EnacheVictor/Voltage-Stabilizer/Proiect docs/CamScanner 2024-11-12 16.13.pdf

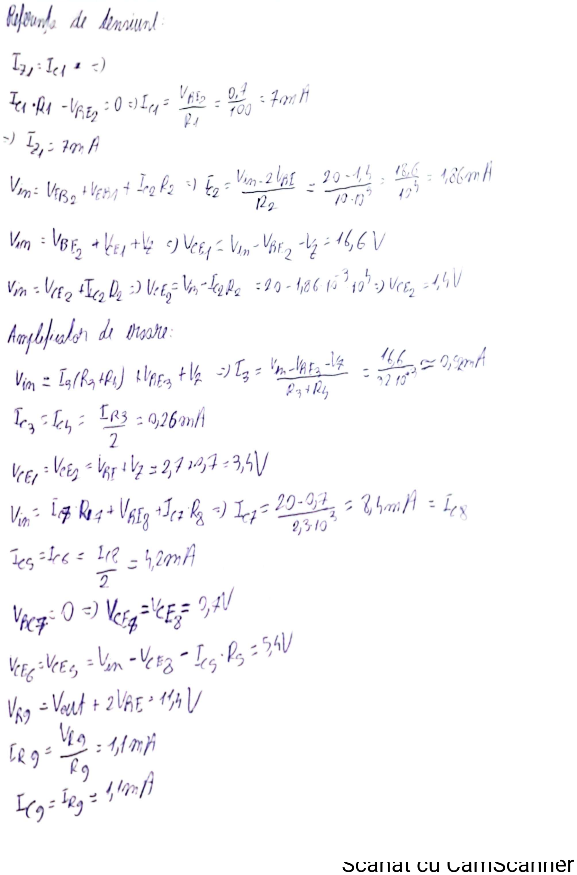
[picture p9: page 1]
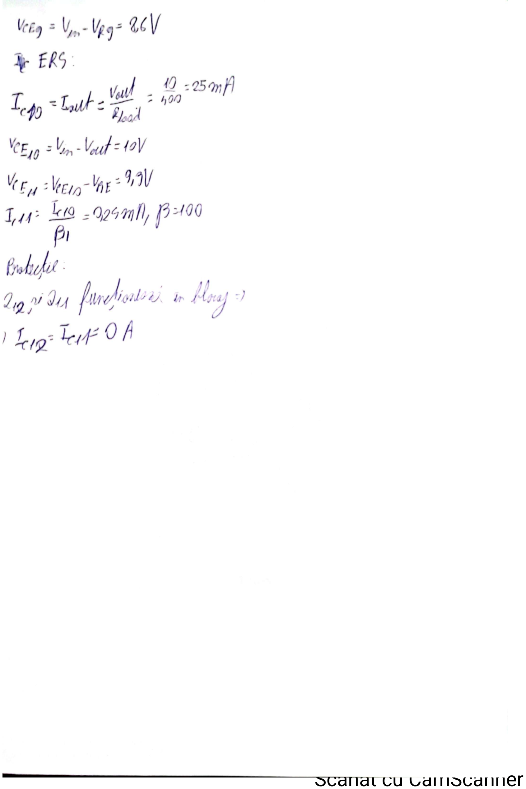
[picture p10: page 2]
