EnacheVictor/Voltage-Stabilizer/Schematics/Proiect1_Enache_Victor.jpg

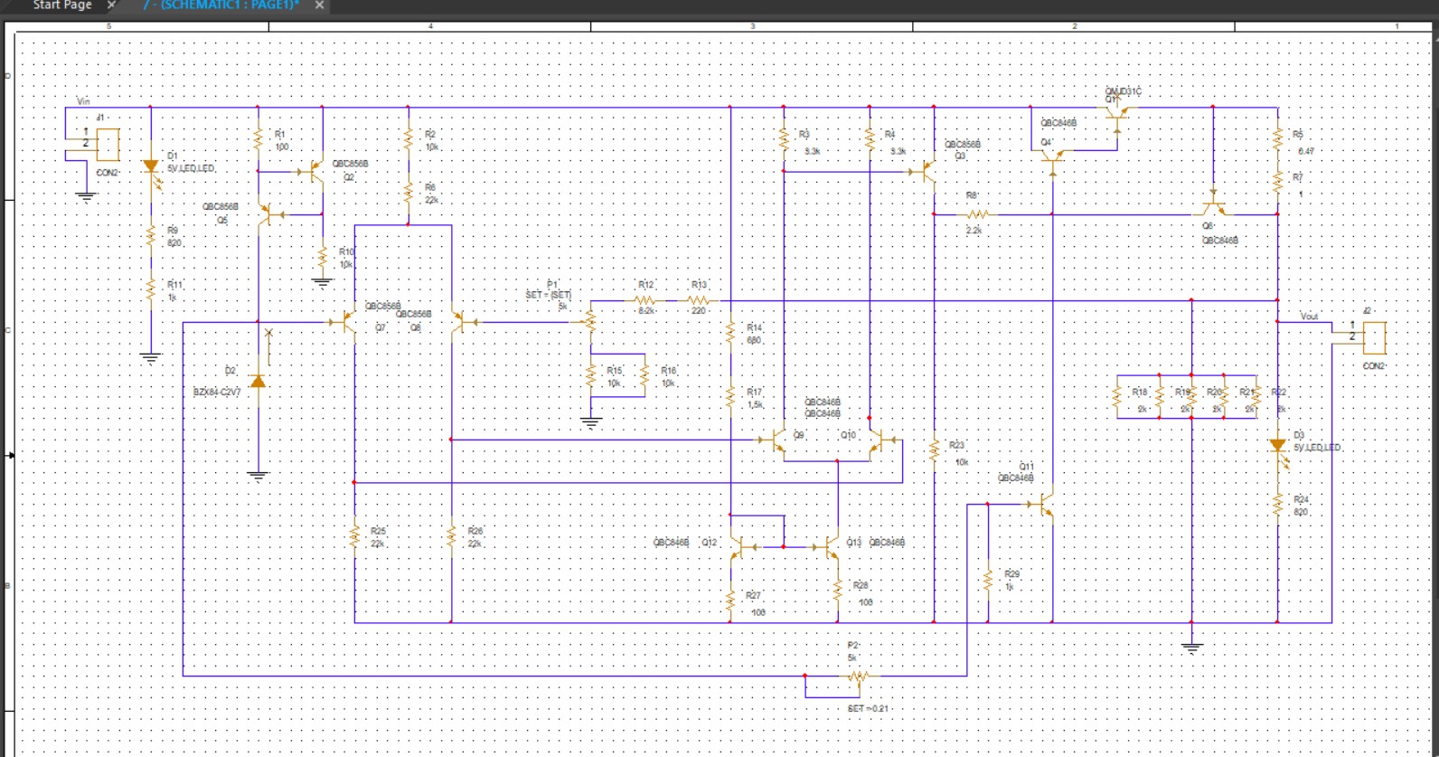
Schematics/Proiect1_Enache_Victor.jpg
