EnacheVictor/Voltage-Stabilizer/Schematics/Proiect/PROIECT1_ENACHEVICTOR.png

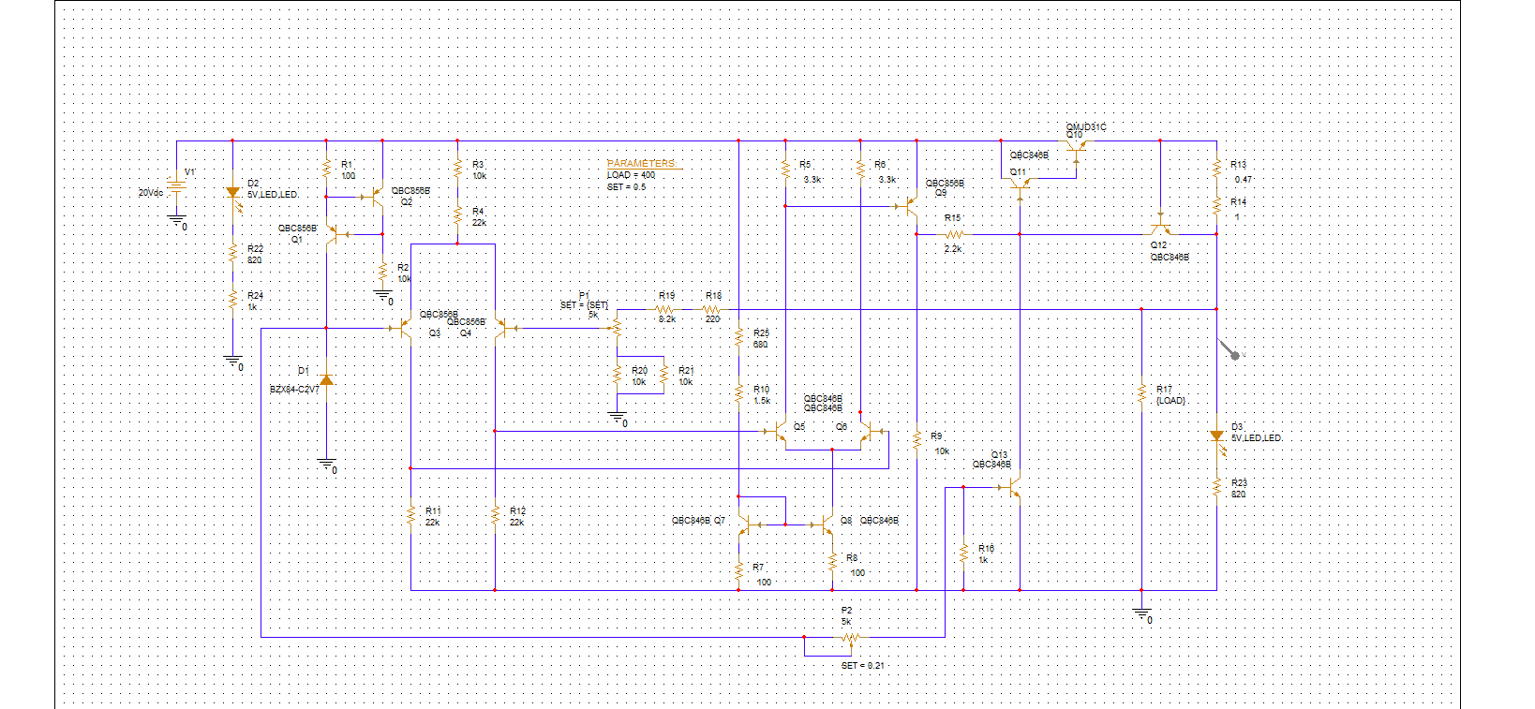
Schematics/Proiect/PROIECT1_ENACHEVICTOR.png
