EnacheVictor/Voltage-Stabilizer/Simulations/bucla deschisa.jpg

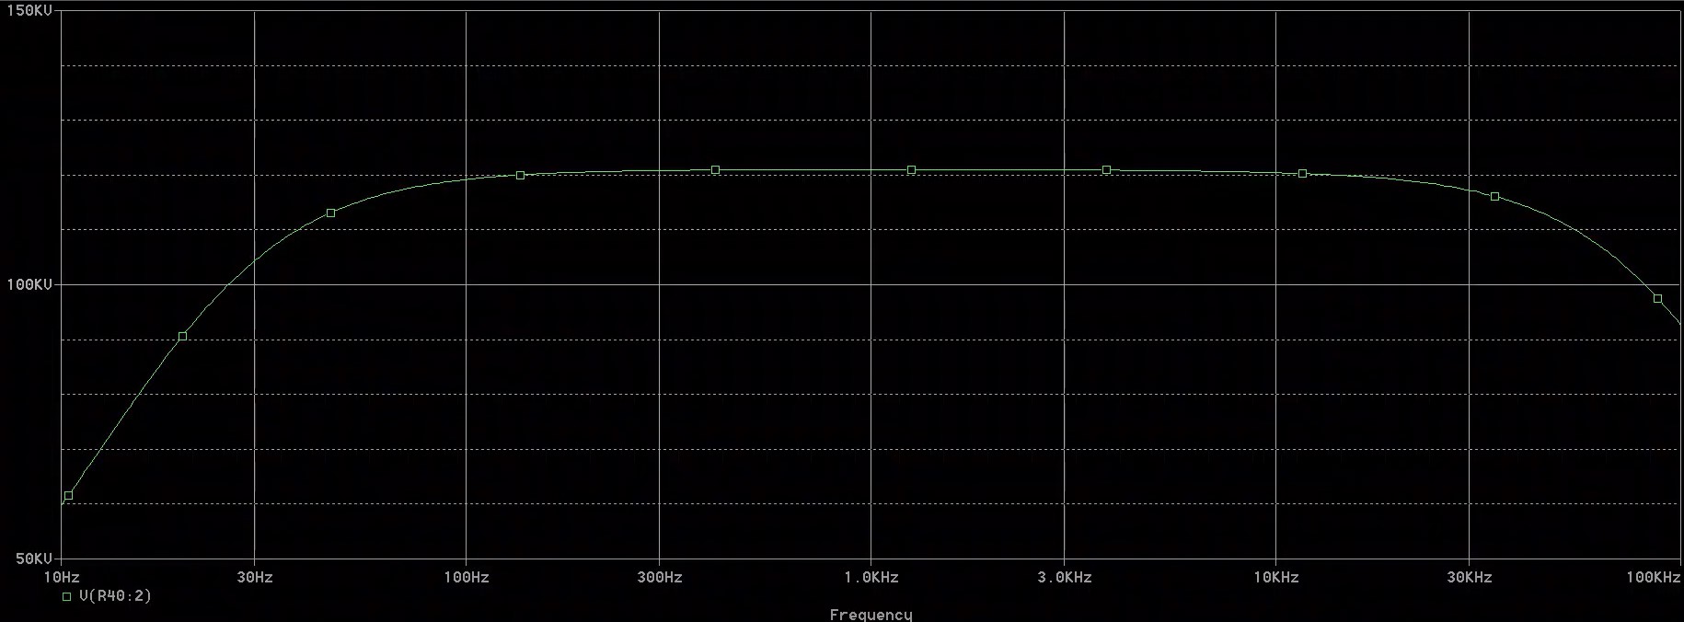
Simulations/bucla deschisa.jpg
