EnacheVictor/Voltage-Stabilizer/Simulations/Protectie supra curent.jpg

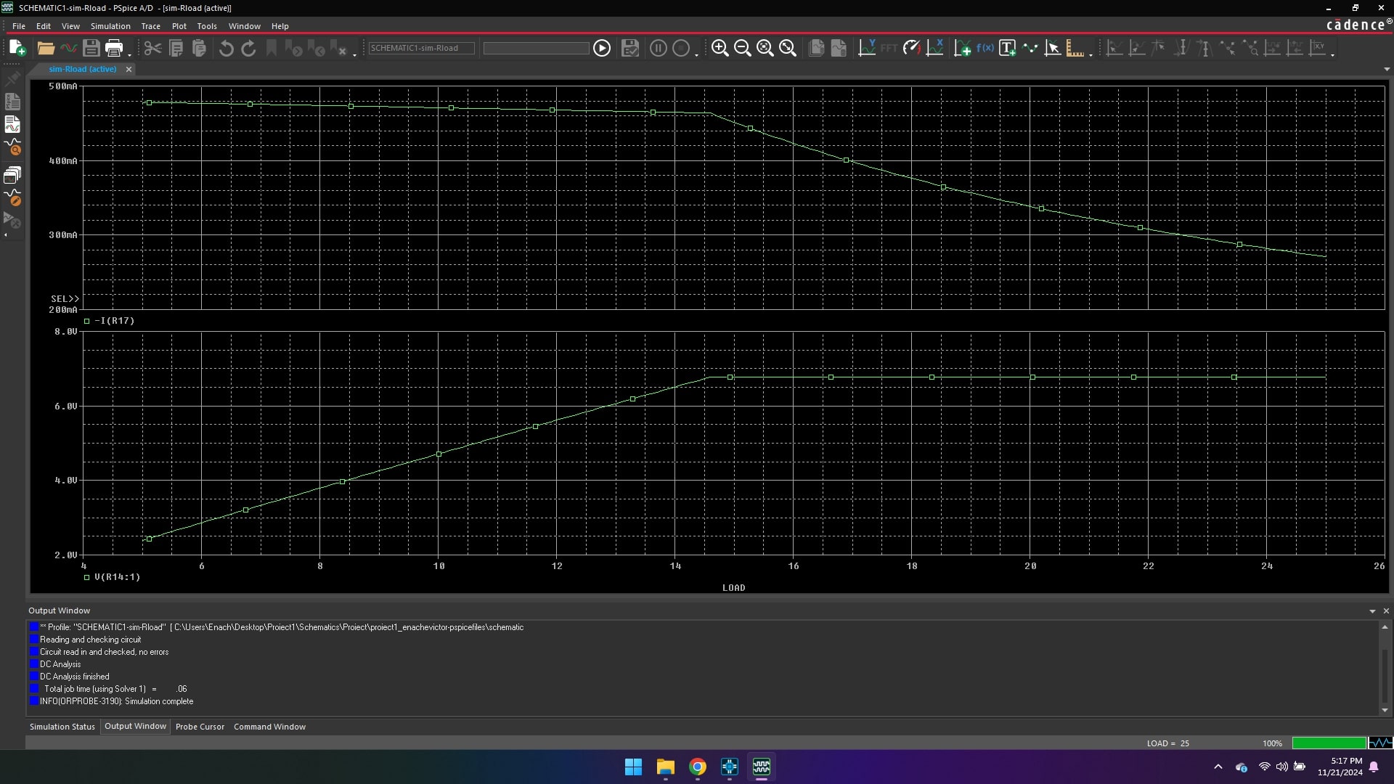
Simulations/Protectie supra curent.jpg
