EnacheVictor/Voltage-Stabilizer/Simulations/protectie temperatura.jpg

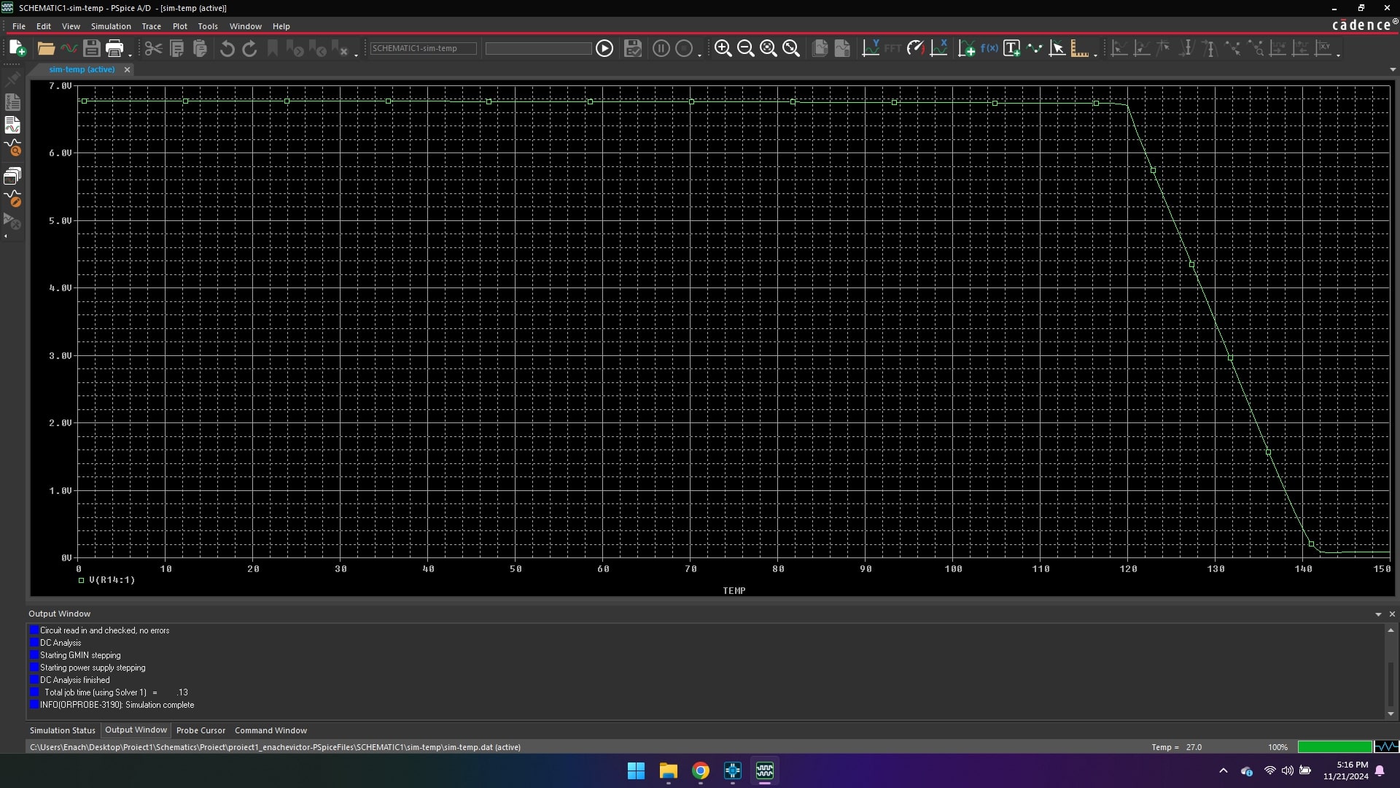
Simulations/protectie temperatura.jpg
