EnacheVictor/Voltage-Stabilizer/Simulations/stabilizator.jpg

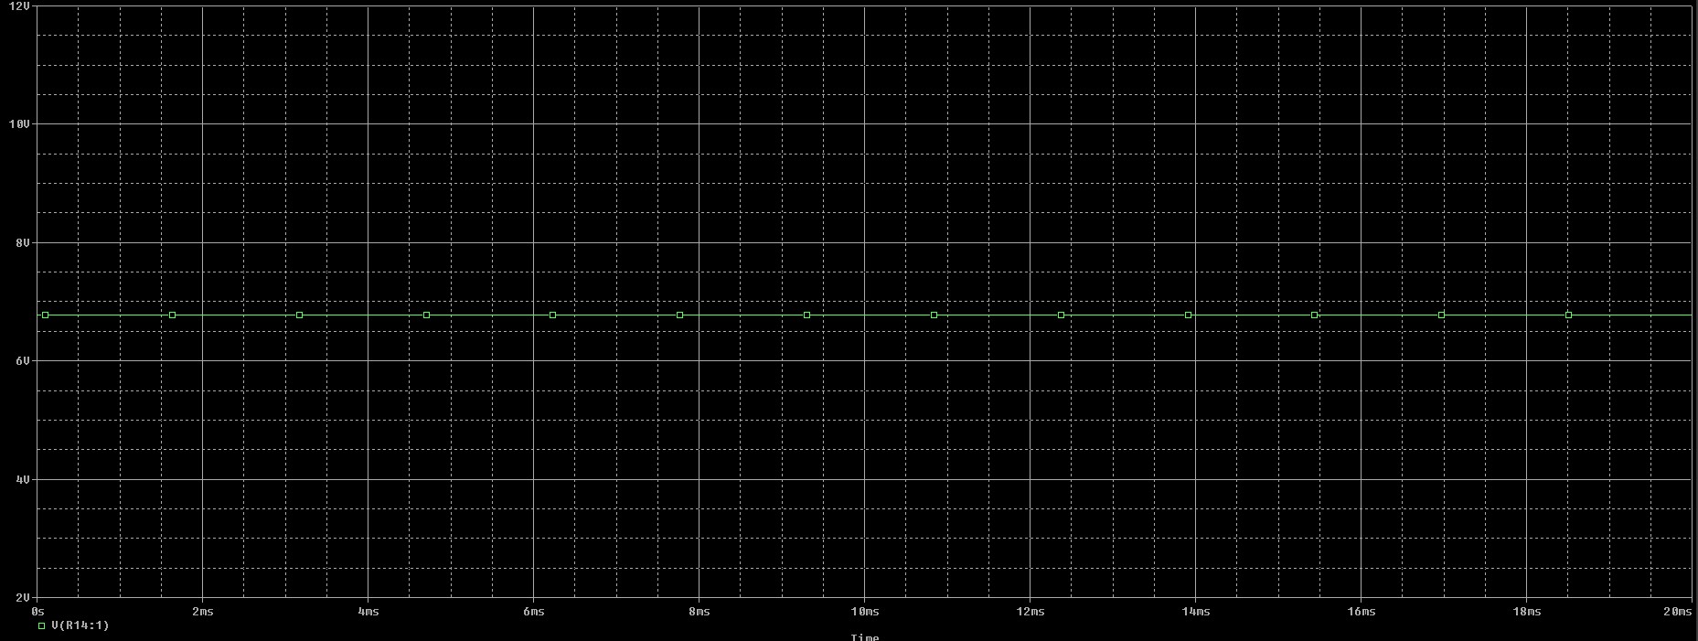
Simulations/stabilizator.jpg
