EnacheVictor/Voltage-Stabilizer/Simulations/Vin 18-20V.jpg

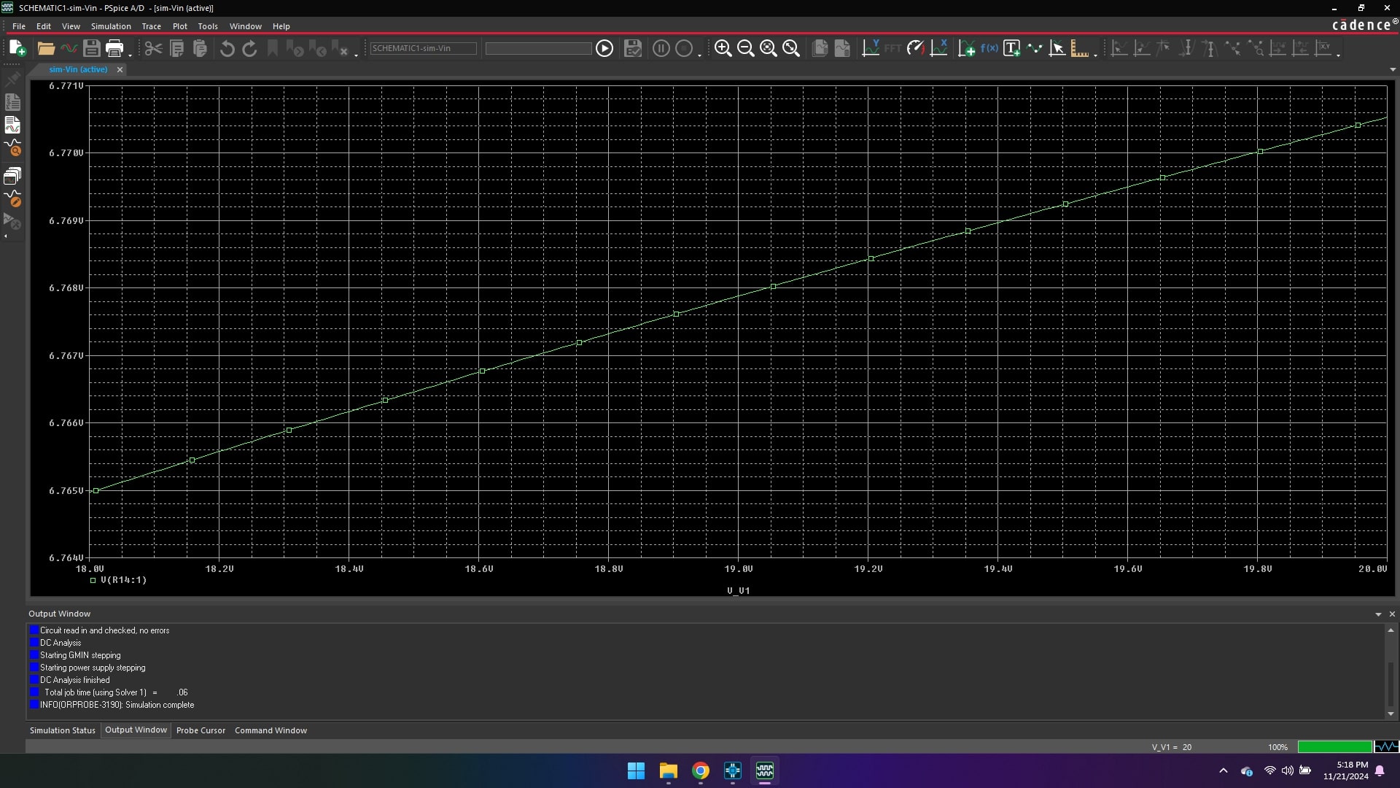
Simulations/Vin 18-20V.jpg
