EnacheVictor/Voltage-Stabilizer/Simulations/Vout 5-10V.jpg

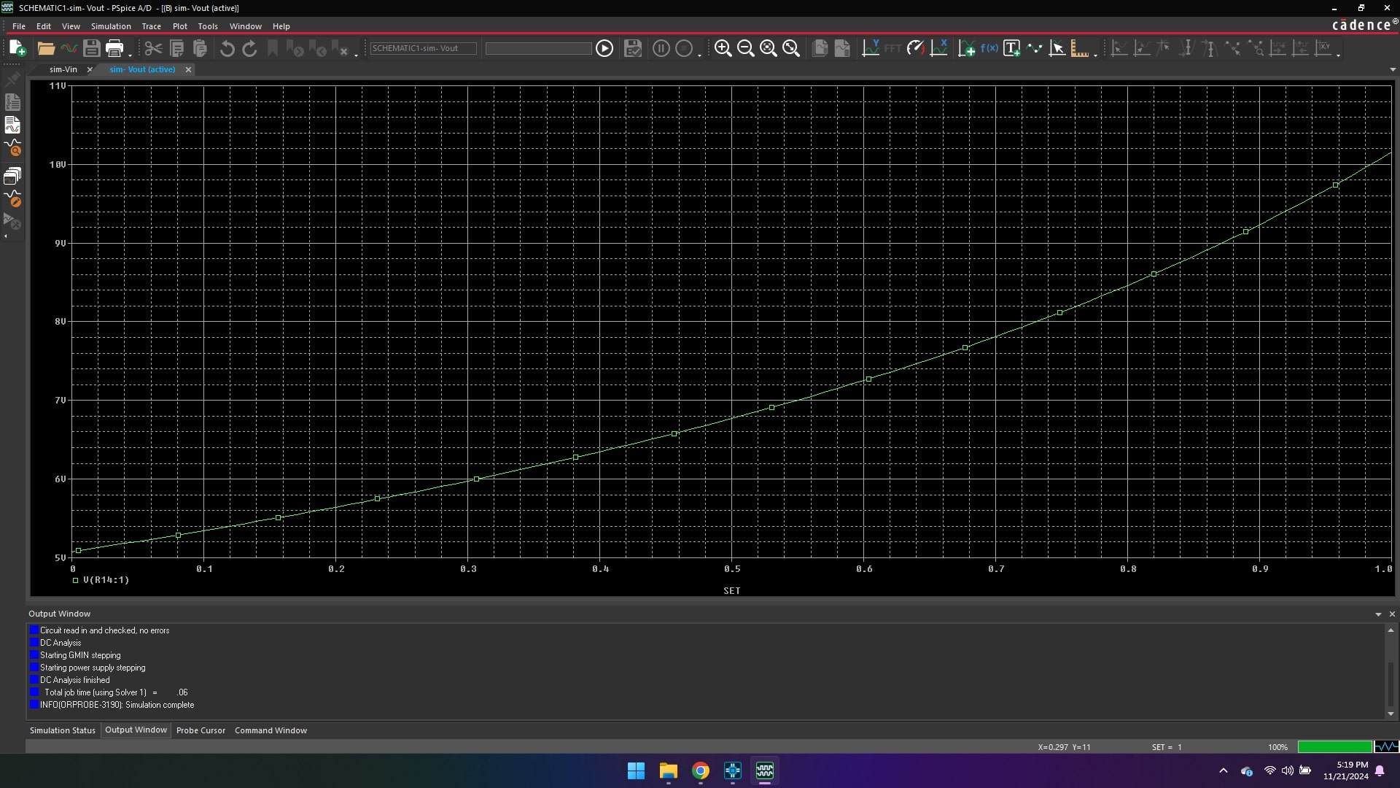
Simulations/Vout 5-10V.jpg
