EnacheVictor/Voltage-Stabilizer/Schematics/MJD31CG.stp

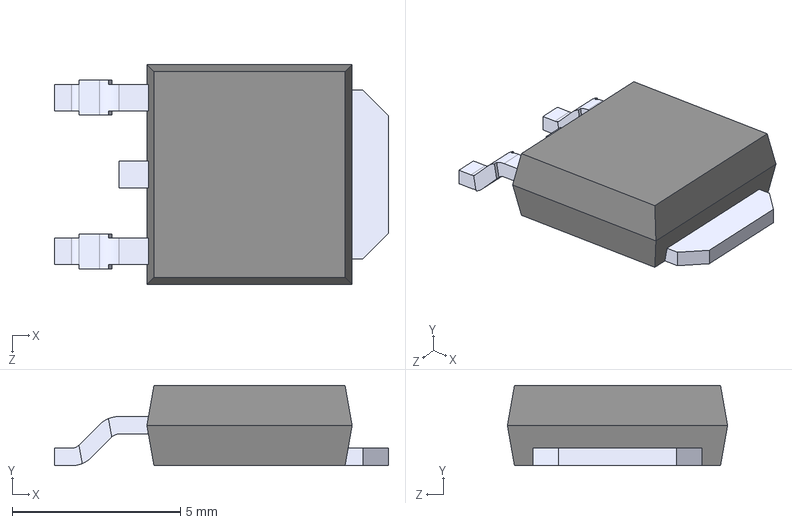
[picture p19: CAD file, 2025-03-27]
Schematics/MJD31CG.stp
9.92 x 2.39 x 6.54 mm
MAC4DCMT4G_5
MAC4DCMT4G
MAC4DCMT4G_4
MAC4DCMT4G_3
MAC4DCMT4G_2
