EnacheVictor/Voltage-Stabilizer/Schematics/BC846B.stp

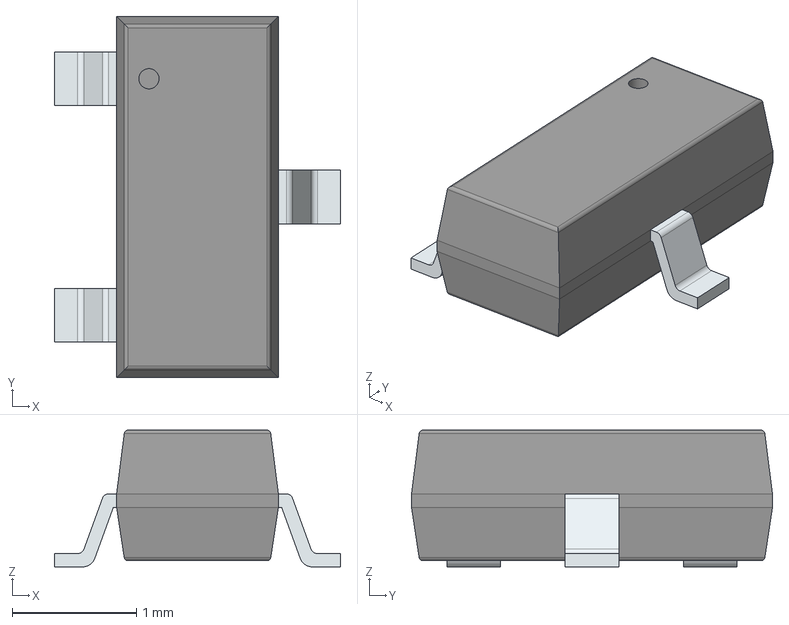
[picture p20: CAD file, 2025-03-27]
Schematics/BC846B.stp
2.30 x 2.90 x 1.10 mm
PinsArrayL
FilletPinR
