EnacheVictor/Voltage-Stabilizer/Schematics/res.stp

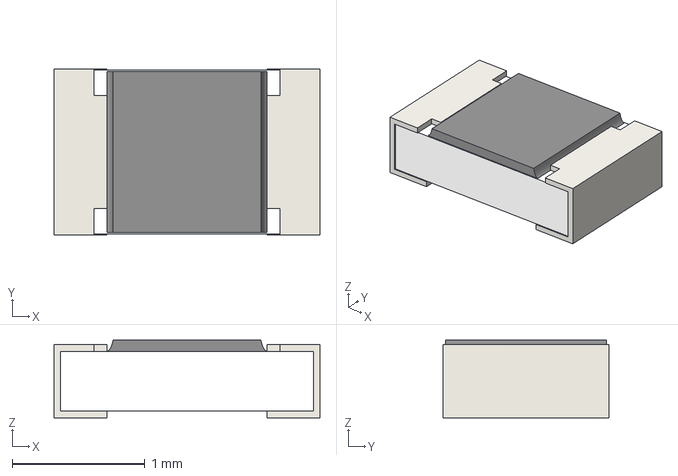
[picture p21: CAD file, 2025-03-27]
Schematics/res.stp
2.00 x 1.25 x 0.585 mm
