EnacheVictor/Voltage-Stabilizer/Schematics/OF-SMD2012B.stp

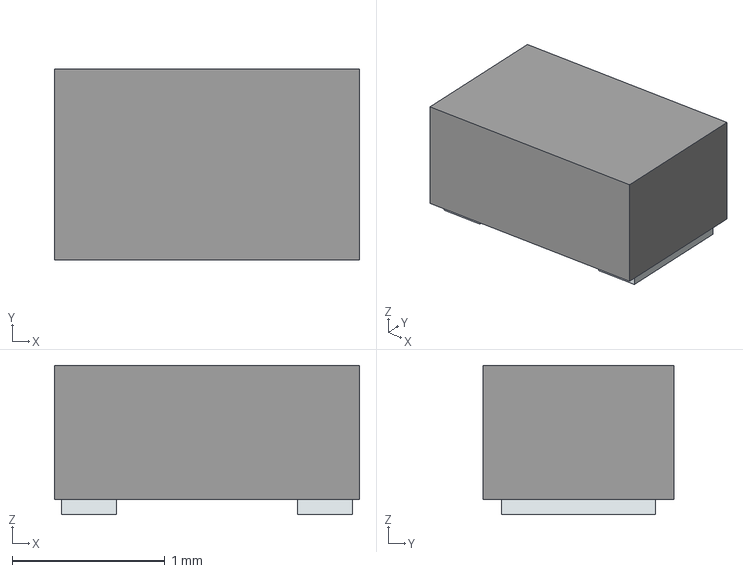
[picture p22: CAD file, 2025-03-27]
Schematics/OF-SMD2012B.stp
2.00 x 1.25 x 0.98 mm
Pins
