EnacheVictor/Voltage-Stabilizer/Schematics/3314G-1-103E.stp

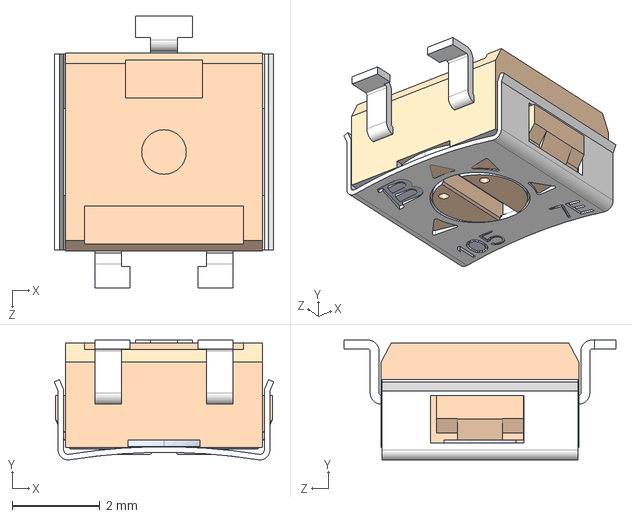
[picture p23: CAD file, 2025-03-27]
Schematics/3314G-1-103E.stp
5.00 x 2.73 x 6.20 mm
