EnacheVictor/Voltage-Stabilizer/Schematics/ZL301-40P.stp

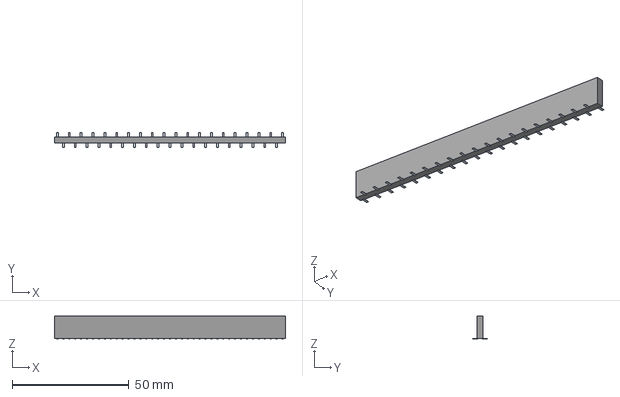
[picture p24: CAD file, 2025-03-27]
Schematics/ZL301-40P.stp
99.1 x 6.50 x 9.80 mm
Pins
