EnacheVictor/Voltage-Stabilizer/(list of files, drawings)

Other design files:
Schematics/biblioteci spice/1N4148.OLB
Schematics/biblioteci spice/1n4148.opj
Schematics/biblioteci spice/BC807-25.OLB
Schematics/biblioteci spice/bc807-25.opj
Schematics/biblioteci spice/BC817-25.OLB
Schematics/biblioteci spice/bc817-25.opj
Schematics/biblioteci spice/BC846B.OLB
Schematics/biblioteci spice/BC856B.OLB
Schematics/biblioteci spice/BZX84C2V7.OLB
Schematics/biblioteci spice/BZX84C5V1.OLB
Schematics/biblioteci spice/BZX84C5V6.OLB
Schematics/biblioteci spice/BZX84C6V2.OLB
Schematics/biblioteci spice/BZX84C6V8.OLB
Schematics/biblioteci spice/BZX84C10.OLB
Schematics/biblioteci spice/diode.olb
Schematics/biblioteci spice/ebipolar.olb
Schematics/biblioteci spice/IRFR120NPBF.OLB
Schematics/biblioteci spice/MJD31CG.OLB
Schematics/biblioteci spice/MJD32CG.OLB
Schematics/biblioteci spice/MMBFJ177LT1G.OLB
Schematics/biblioteci spice/MMBFJ309LT1G.OLB
Schematics/biblioteci spice/opto.olb
Schematics/PROIECT1_ENACHEVICTOR.DSN
Schematics/Proiect1_EnacheVictor.opj
Schematics/Proiect/biblioteci spice/1N4148.OLB
Schematics/Proiect/biblioteci spice/1n4148.opj
Schematics/Proiect/biblioteci spice/BC807-25.OLB
Schematics/Proiect/biblioteci spice/bc807-25.opj
Schematics/Proiect/biblioteci spice/BC817-25.OLB
Schematics/Proiect/biblioteci spice/bc817-25.opj
Schematics/Proiect/biblioteci spice/BC846B.OLB
Schematics/Proiect/biblioteci spice/BC856B.OLB
Schematics/Proiect/biblioteci spice/BZX84C2V7.OLB
Schematics/Proiect/biblioteci spice/BZX84C5V1.OLB
Schematics/Proiect/biblioteci spice/BZX84C5V6.OLB
Schematics/Proiect/biblioteci spice/BZX84C6V2.OLB
Schematics/Proiect/biblioteci spice/BZX84C6V8.OLB
Schematics/Proiect/biblioteci spice/BZX84C10.OLB
Schematics/Proiect/biblioteci spice/diode.olb
Schematics/Proiect/biblioteci spice/ebipolar.olb
Schematics/Proiect/biblioteci spice/IRFR120NPBF.OLB
Schematics/Proiect/biblioteci spice/MJD31CG.OLB
Schematics/Proiect/biblioteci spice/MJD32CG.OLB
Schematics/Proiect/biblioteci spice/MMBFJ177LT1G.OLB
Schematics/Proiect/biblioteci spice/MMBFJ309LT1G.OLB
Schematics/Proiect/biblioteci spice/opto.olb
Schematics/Proiect/PROIECT1_ENACHEVICTOR.DSN
Schematics/Proiect/Proiect1_EnacheVictor.opj
